uw-herron-lab/NeuroTest-Board/design_files/README.md

Parts acquisition and PCB production can be done through any supplier or partner that an end users chooses. While we do not endorse or support exclusive use of any manufacture or vendor, we provide information below detailing how we initially handled parts acquisition:

PCBs and the majority of parts were initially acquired through JLCPCB (https://jlcpcb.com/). The zipped folder containing the Gerber files can be uploaded to generate the PCB. The bom (and cpl) file contained in this subfolder can be uploaded to JLCPCB to generate an order of available parts. Parts that were not available through JLC were searched for on digipart (https://www.digipart.com/) and acquired through other suppliers like Digi-key or Unikey.

Another option used for initial parts ordering by one of our teams was LCSC (https://www.lcsc.com/). Again, parts that were not available were acquired on Digi-key or Unikey. NOTE: the "1Meg" component is a 1 mega Ohm (1Mohm) resistor with a 0603 footprint. LCSC appears to not register this part but it can be found by searching manually for these specifications. For example searching for 1M ohm 0603 will give you parts that work, including Part number: RC0603FR-071ML from YAGEO.

Though not a necessary service for NTB assembly, vendors like JLCPCB will both create the PCB and mount components (e.g., integrated circuits/ICs) that they are able to supply. End users should double check that the components are oriented correctly between the cpl and PCB layout. We used JLC to assemble most of the components, however, the BNC connectors (j1, J5, J6, J7), Teensy board (IC8), and power supply (PS1) were SMD soldered onto the PCBs by the labs themselves. 

The LED1, IC26, and IC27 components are not placed. SJ2 and SJ3 are pads and are not actual components (i.e., are also not placed).
