uw-herron-lab/NeuroTest-Board/data_files/README.md

Data that can be used with the signal generator function of the NTB can be found at the linked Open Science Framework repository (link: https://osf.io/3v24t/overview).
