uw-herron-lab/NeuroTest-Board/design_files/Sensing_circuit_diagram.png

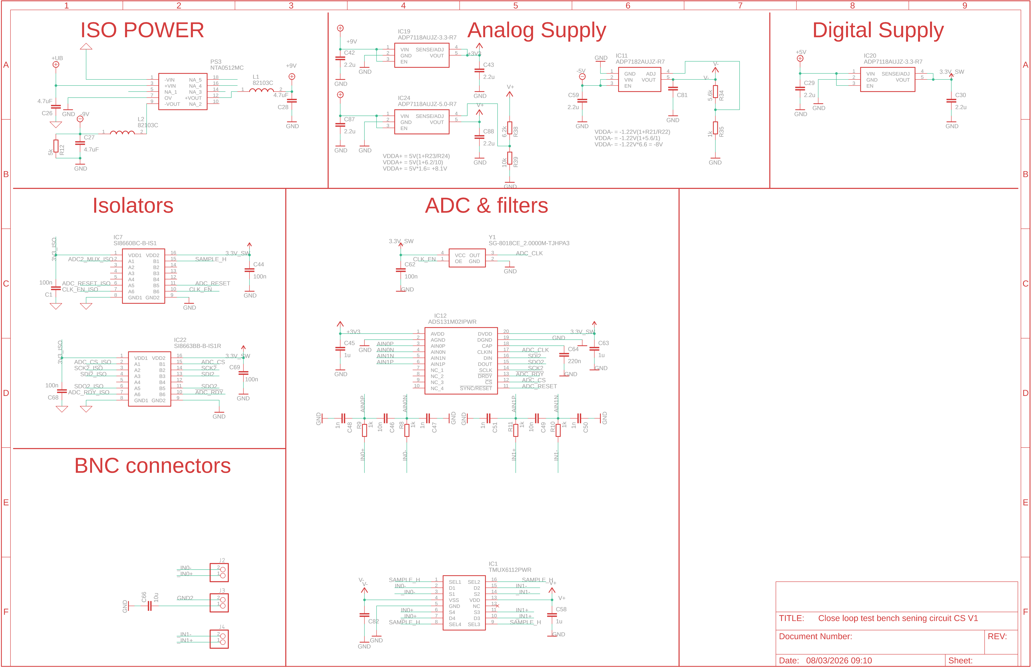
design_files/Sensing_circuit_diagram.png
