uw-herron-lab/NeuroTest-Board/design_files/NeuroTest board BOM and Digikey Order.xlsx

Sheet: BOM
Reference | Qty | Value | DNP | Exclude from BOM | Exclude from Board | Exclude from Simulation | Exclude from Position Files | Footprint | Datasheet
C2,C26,C27,C28 | 4 | 4.7uF |  |  |  |  | ${EXCLUDE_FROM_POS_FILES} | NeuroTest board current source 2 channel V1_1:C0603
C3,C54 | 2 | 1uF |  |  |  |  | ${EXCLUDE_FROM_POS_FILES} | NeuroTest board current source 2 channel V1_1:C0603
C4,C55 | 2 | 3.3uF |  |  |  |  | ${EXCLUDE_FROM_POS_FILES} | NeuroTest board current source 2 channel V1_1:C0603
C5,C6,C7,C8,C9,C10,C12,C14,C17,C20,C21,C29,C30,C42,C43,C52,C53,C60,C61,C67,C71,C75 | 22 | 2.2u |  |  |  |  | ${EXCLUDE_FROM_POS_FILES} | NeuroTest board current source 2 channel V1_1:C0603
C11,C13,C16,C45,C63,C65,C70,C74 | 8 | 1u |  |  |  |  | ${EXCLUDE_FROM_POS_FILES} | NeuroTest board current source 2 channel V1_1:C0603
C15,C73 | 2 | 3.3uF |  |  |  |  | ${EXCLUDE_FROM_POS_FILES} | NeuroTest board current source 2 channel V1_1:C0805
C18,C76 | 2 | 15p |  |  |  |  | ${EXCLUDE_FROM_POS_FILES} | NeuroTest board current source 2 channel V1_1:C0603
C22,C24,C31,C32,C62,C68,C69,C72 | 8 | 100n |  |  |  |  | ${EXCLUDE_FROM_POS_FILES} | NeuroTest board current source 2 channel V1_1:C0603
C46,C49 | 2 | 10n |  |  |  |  | ${EXCLUDE_FROM_POS_FILES} | NeuroTest board current source 2 channel V1_1:C0603
C47,C48,C50,C51 | 4 | 1n |  |  |  |  | ${EXCLUDE_FROM_POS_FILES} | NeuroTest board current source 2 channel V1_1:C0603
C56,C57,C83,C84 | 4 | 100nF |  |  |  |  | ${EXCLUDE_FROM_POS_FILES} | NeuroTest board current source 2 channel V1_1:C0603
C64 | 1 | 220n |  |  |  |  | ${EXCLUDE_FROM_POS_FILES} | NeuroTest board current source 2 channel V1_1:C0603
C66 | 1 | 10u |  |  |  |  | ${EXCLUDE_FROM_POS_FILES} | NeuroTest board current source 2 channel V1_1:C0603
DAC1,DAC3 | 2 | DAC8831ID |  |  |  |  | ${EXCLUDE_FROM_POS_FILES} | NeuroTest board current source 2 channel V1_1:SOIC127P600X175-14N
IC2,IC3,IC14,IC15 | 4 | OPA2192IDR_BKN |  |  |  |  | ${EXCLUDE_FROM_POS_FILES} | NeuroTest board current source 2 channel V1_1:SOIC127P600X175-8N
IC4 | 1 | SI8660BC-B-IS1 |  |  |  |  | ${EXCLUDE_FROM_POS_FILES} | NeuroTest board current source 2 channel V1_1:SOIC127P600X175-16N
IC6 | 1 | SI8663BB-B-IS1R |  |  |  |  | ${EXCLUDE_FROM_POS_FILES} | NeuroTest board current source 2 channel V1_1:SOIC127P600X175-16N
IC8 | 1 | TEENSY_4.1 |  |  |  |  | ${EXCLUDE_FROM_POS_FILES} | NeuroTest board current source 2 channel V1_1:TEENSY41
IC10,IC18,IC21 | 3 | ADP7118AUJZ-5.0-R7 |  |  |  |  | ${EXCLUDE_FROM_POS_FILES} | NeuroTest board current source 2 channel V1_1:SOT95P280X100-5N
IC12 | 1 | ADS131M02IPWR |  |  |  |  | ${EXCLUDE_FROM_POS_FILES} | NeuroTest board current source 2 channel V1_1:SOP65P640X120-20N
IC19,IC20 | 2 | ADP7118AUJZ-3.3-R7 |  |  |  |  | ${EXCLUDE_FROM_POS_FILES} | NeuroTest board current source 2 channel V1_1:SOT95P280X100-5N
IC22 | 1 | SI8662AB-B-IS1 |  |  |  |  | ${EXCLUDE_FROM_POS_FILES} | NeuroTest board current source 2 channel V1_1:SOIC127P600X175-16N
IC23,IC28 | 2 | OPA192IDGKT |  |  |  |  | ${EXCLUDE_FROM_POS_FILES} | NeuroTest board current source 2 channel V1_1:SOP65P490X110-8N
IC25 | 1 | ADP7182AUJZ-R7 |  |  |  |  | ${EXCLUDE_FROM_POS_FILES} | NeuroTest board current source 2 channel V1_1:SOT95P280X100-5N
IC26,IC27 | 2 | TXU0101DCKR |  |  |  |  | ${EXCLUDE_FROM_POS_FILES} | NeuroTest board current source 2 channel V1_1:SOT65P210X110-6N
J1,J5,J6,J7 | 4 | B6252H5-NPP3G-50 |  |  |  |  | ${EXCLUDE_FROM_POS_FILES} | NeuroTest board current source 2 channel V1_1:B6252H5NPP3G50
J3,TTL_IN0 | 2 | JST_2PIN-THM |  |  |  |  | ${EXCLUDE_FROM_POS_FILES} | NeuroTest board current source 2 channel V1_1:JST-PH-2-THM
L1,L2 | 2 | 82103C |  |  |  |  | ${EXCLUDE_FROM_POS_FILES} | NeuroTest board current source 2 channel V1_1:8200
LED1 | 1 | WS2812B-B_W |  |  |  |  | ${EXCLUDE_FROM_POS_FILES} | NeuroTest board current source 2 channel V1_1:WS2812BBW
LEDS0 | 1 | 2355045-4 |  |  |  |  | ${EXCLUDE_FROM_POS_FILES} | NeuroTest board current source 2 channel V1_1:HDRV4W50P0X200_1X4_800X200X550
PS1 | 1 | TMH_0515D |  |  |  |  | ${EXCLUDE_FROM_POS_FILES} | NeuroTest board current source 2 channel V1_1:TMH0515D
PS3 | 1 | NTA0505MC |  |  |  |  | ${EXCLUDE_FROM_POS_FILES} | NeuroTest board current source 2 channel V1_1:SOP254P1080X685-10N
R1 | 1 | 10.5k |  |  |  |  | ${EXCLUDE_FROM_POS_FILES} | NeuroTest board current source 2 channel V1_1:R0603
R2,R8,R9,R10,R11,R12 | 6 | 1k |  |  |  |  | ${EXCLUDE_FROM_POS_FILES} | NeuroTest board current source 2 channel V1_1:R0603
R3,R4,R5,R6,R13,R16,R18,R24,R43,R44,R45,R46,R49,R52,R54 | 15 | 10k |  |  |  |  | ${EXCLUDE_FROM_POS_FILES} | NeuroTest board current source 2 channel V1_1:R0603
R7,R19,R20,R47,R55,R57 | 6 | 100k |  |  |  |  | ${EXCLUDE_FROM_POS_FILES} | NeuroTest board current source 2 channel V1_1:R0603
R14,R50 | 2 | 20k |  |  |  |  | ${EXCLUDE_FROM_POS_FILES} | NeuroTest board current source 2 channel V1_1:R0603
R15,R17,R51,R53 | 4 | 499 |  |  |  |  | ${EXCLUDE_FROM_POS_FILES} | NeuroTest board current source 2 channel V1_1:R0603
R23 | 1 | 28k |  |  |  |  | ${EXCLUDE_FROM_POS_FILES} | NeuroTest board current source 2 channel V1_1:R0603
R29,R30 | 2 | 1Meg |  |  |  |  | ${EXCLUDE_FROM_POS_FILES} | NeuroTest board current source 2 channel V1_1:R0603
R48,R56 | 2 | 680 |  |  |  |  | ${EXCLUDE_FROM_POS_FILES} | NeuroTest board current source 2 channel V1_1:R0603
SJ2,SJ3 | 2 | SJ2W |  |  |  |  | ${EXCLUDE_FROM_POS_FILES} | NeuroTest board current source 2 channel V1_1:SJ_2
Y1 | 1 | SG-8018CE_2.0000M-TJHPA3 |  |  |  |  | ${EXCLUDE_FROM_POS_FILES} | NeuroTest board current source 2 channel V1_1:SG8018CE20000MTJHPA3
 | 137

Sheet: DigiKey Parts
ICs
Reference | Qty | Value | DigiKey Part Number | DigiKey link
IC19 IC20 | 2 | ADP7118AUJZ-3.3-R7 | 505-ADP7118AUJZ-3.3-R7CT-ND | DigiKey (https://www.digikey.com/en/products/detail/analog-devices-inc/ADP7118AUJZ-3-3-R7/5056890)
IC10 IC18 IC21 | 3 | ADP7118AUJZ-5.0-R7 | 505-ADP7118AUJZ-5.0-R7CT-ND | DigiKey (https://www.digikey.com/en/products/detail/analog-devices-inc/ADP7118AUJZ-5-0-R7/5056891)
IC25 | 1 | ADP7182AUJZ-R7 | 505-ADP7182AUJZ-R7CT-ND | DigiKey (https://www.digikey.com/en/products/detail/analog-devices-inc/ADP7182AUJZ-R7/4901225)
IC12 | 1 | ADS131M02IPWR | 296-ADS131M02IPWRCT-ND | DigiKey (https://www.digikey.com/en/products/detail/texas-instruments/ADS131M02IPWR/15857267)
DAC1 DAC3 | 2 | DAC8831ID | 296-18030-5-ND | DigiKey (https://www.digikey.com/en/products/detail/texas-instruments/DAC8831ID/770869?utm_source=chatgpt.com)
PS3 | 1 | NTA0505MC | 811-1665-5-ND | DigiKey (https://www.digikey.com/en/products/detail/murata-power-solutions-inc/NTA0505MC/1927226)
IC23 IC28 | 2 | OPA192IDGKT | 296-42442-1-ND | DigiKey (https://www.digikey.com/en/products/detail/texas-instruments/OPA192IDGKT/5405191)
IC2 IC3 IC14 IC15 | 4 | OPA2192IDR_BKN | 296-42106-1-ND | DigiKey (https://www.digikey.com/en/products/detail/texas-instruments/OPA2192IDR/5252859)
IC4 | 1 | SI8660BC-B-IS1 | 336-2114-5-ND | DigiKey (https://www.digikey.com/en/products/detail/skyworks-solutions-inc/SI8660BC-B-IS1/2623362)
IC22 | 1 | SI8662AB-B-IS1 | SI8662AB-B-IS1-ND | DigiKey (https://www.digikey.com/en/products/detail/skyworks-solutions-inc/SI8662AB-B-IS1/4576760)
IC6 | 1 | SI8663BB-B-IS1R | 336-4949-1-ND | DigiKey (https://www.digikey.com/en/products/detail/skyworks-solutions-inc/SI8663BB-B-IS1R/4576621)
PS1 | 1 | TMH 0515D | 1951-2669-ND | DigiKey (https://www.digikey.com/en/products/detail/traco-power/TMH-0515D/9383703?utm_source=chatgpt.com)
IC8 | 1 | TEENSY 4.1 | 1568-16996-ND | DigiKey (https://www.digikey.com/en/products/detail/sparkfun-electronics/16996/13158152)
Resistors
Reference | Qty | Value | DigiKey Part Number | DigiKey link
R29 R30 | 2 | 1 MΩ | 311-1.00MHRCT-ND | DigiKey (https://www.digikey.com/en/products/detail/yageo/RC0603FR-071ML/729791?utm_source=chatgpt.com)
R2 R8 R9 R10 R11 R12 | 6 | 1 kΩ | 311-1.00KHRCT-ND | DigiKey (https://www.digikey.com/en/products/detail/yageo/RC0603FR-071KL/729790?utm_source=chatgpt.com)
R1 | 1 | 10.5 kΩ | 311-10.5KHRCT-ND | DigiKey (https://www.digikey.com/en/products/detail/yageo/RC0603FR-0710K5L/729832?utm_source=chatgpt.com)
R3 R4 R5 R6 R13 R16 R18 R24 R43 R44 R45 R46 R49 R52 R54 | 15 | 10 kΩ | 311-10.0KHRCT-ND | DigiKey (https://www.digikey.com/en/products/detail/yageo/RC0603FR-0710KL/729827?utm_source=chatgpt.com)
R14 R50 | 2 | 20 kΩ | 311-20.0KHRCT-ND | DigiKey (https://www.digikey.com/en/products/detail/yageo/RC0603FR-0720KL/727040)
R23 | 1 | 28 kΩ | 311-28.0KHRCT-ND | DigiKey (https://www.digikey.com/en/products/detail/yageo/RC0603FR-0728KL/727108?utm_source=chatgpt.com)
R7 R19 R20 R47 R55 R57 | 6 | 100 kΩ | 311-100KHRCT-ND | DigiKey (https://www.digikey.com/en/products/detail/yageo/RC0603FR-07100KL/726889?utm_source=chatgpt.com)
R15 R17 R51 R53 | 4 | 499 Ω | 311-499HRCT-ND | DigiKey (https://www.digikey.com/en/products/detail/yageo/RC0603FR-07499RL/727266?utm_source=chatgpt.com)
R48 R56 | 2 | 680 Ω | 311-680HRCT-ND | DigiKey (https://www.digikey.com/en/products/detail/yageo/RC0603FR-07680RL/730302?utm_source=chatgpt.com)
Capacitors
Reference | Qty | Value | DigiKey Part Number | DigiKey link | Notes
C18 C76 | 2 | 15 pF | 399-C0603C150J5GACTUCT-ND | DigiKey (https://www.digikey.com/en/products/detail/kemet/C0603C150J5GACTU/411053?utm_source=chatgpt.com)
C47 C48 C50 C51 | 4 | 1 nF | 399-C0603C102J5GACTUCT-ND | DigiKey (https://www.digikey.com/en/products/detail/kemet/C0603C102J5GACTU/608471?utm_source=chatgpt.com)
C46 C49 | 2 | 10 nF | 490-9666-1-ND | DigiKey (https://www.digikey.com/en/products/detail/murata-electronics/GRM1885C1H103JA01D/4421555)
C22 C24 C31 C32 C56 C57 C62 C68 C69 C72 C83 C84 | 12 | 100 nF | 399-C0603C104K5RACTUCT-ND | DigiKey (https://www.digikey.com/en/products/detail/kemet/C0603C104K5RACTU/1465623?utm_source=chatgpt.com)
C64 | 1 | 220 nF | 490-5402-1-ND | DigiKey (https://www.digikey.com/en/products/detail/murata-electronics/GCM188R71H224KA64D/2123159)
C3 C11 C13 C16 C45 C54 C63 C65 C70 C74 | 10 | 1 µF | 445-12484-1-ND | DigiKey (https://www.digikey.com/en/products/detail/tdk-corporation/CGA3E3X5R1V105K080AB/3954150)
C5 C6 C7 C8 C9 C10 C12 C14 C17 C20 C21 C29 C30 C42 C43 C52 C53 C60 C61 C67 C71 C75 | 22 | 2.2 µF | 490-7204-1-ND | DigiKey (https://www.digikey.com/en/products/detail/murata-electronics/GRM188R6YA225KA12D/3900462)
C4 C15 C55 C73 | 4 | 3.3 µF | 445-14167-1-ND | DigiKey (https://www.digikey.com/en/products/detail/tdk-corporation/C1608X5R1V335K080AC/3955833) | C15 and C73 are supposed to be 0805 (2012) but the 0603 (1608) work
C2 C26 C27 C28 | 4 | 4.7 µF | 490-GRM188R6YA475KE15JCT-ND | DigiKey (https://www.digikey.com/en/products/detail/murata-electronics/GRM188R6YA475KE15J/4905369)
C66 | 1 | 10 µF | 490-GRM188R6YA106MA73JTR-ND | DigiKey (https://www.digikey.com/en/products/detail/murata-electronics/GRM188R6YA106MA73J/13693159)
Everything Else
Reference | Qty | Value | DigiKey Part Number | DigiKey link
J1 J5 J6 J7 | 4 | B6252H5-NPP3G-50 | ARF1690-ND | DigiKey (https://www.digikey.com/en/products/detail/amphenol-rf/031-5431-10RFX/2041816?utm_source=chatgpt.com)
Y1 | 1 | SG-8018CE 2.048000MHz TJHPA | SG-8018CE-TJHPA-ND † | DigiKey (https://www.digikey.com/en/products/detail/epson/SG-8018CE-TJHPA/7784068)
L1 L2 | 2 | 82103C | 811-2473-1-ND | DigiKey (https://www.digikey.com/en/products/detail/murata-power-solutions-inc/82103C/3178927)
