uw-herron-lab/NeuroTest-Board/design_files/NTB_schematic.kicad_sch

## KiCad design design_files/NTB_schematic.kicad_sch (2026-09-11)

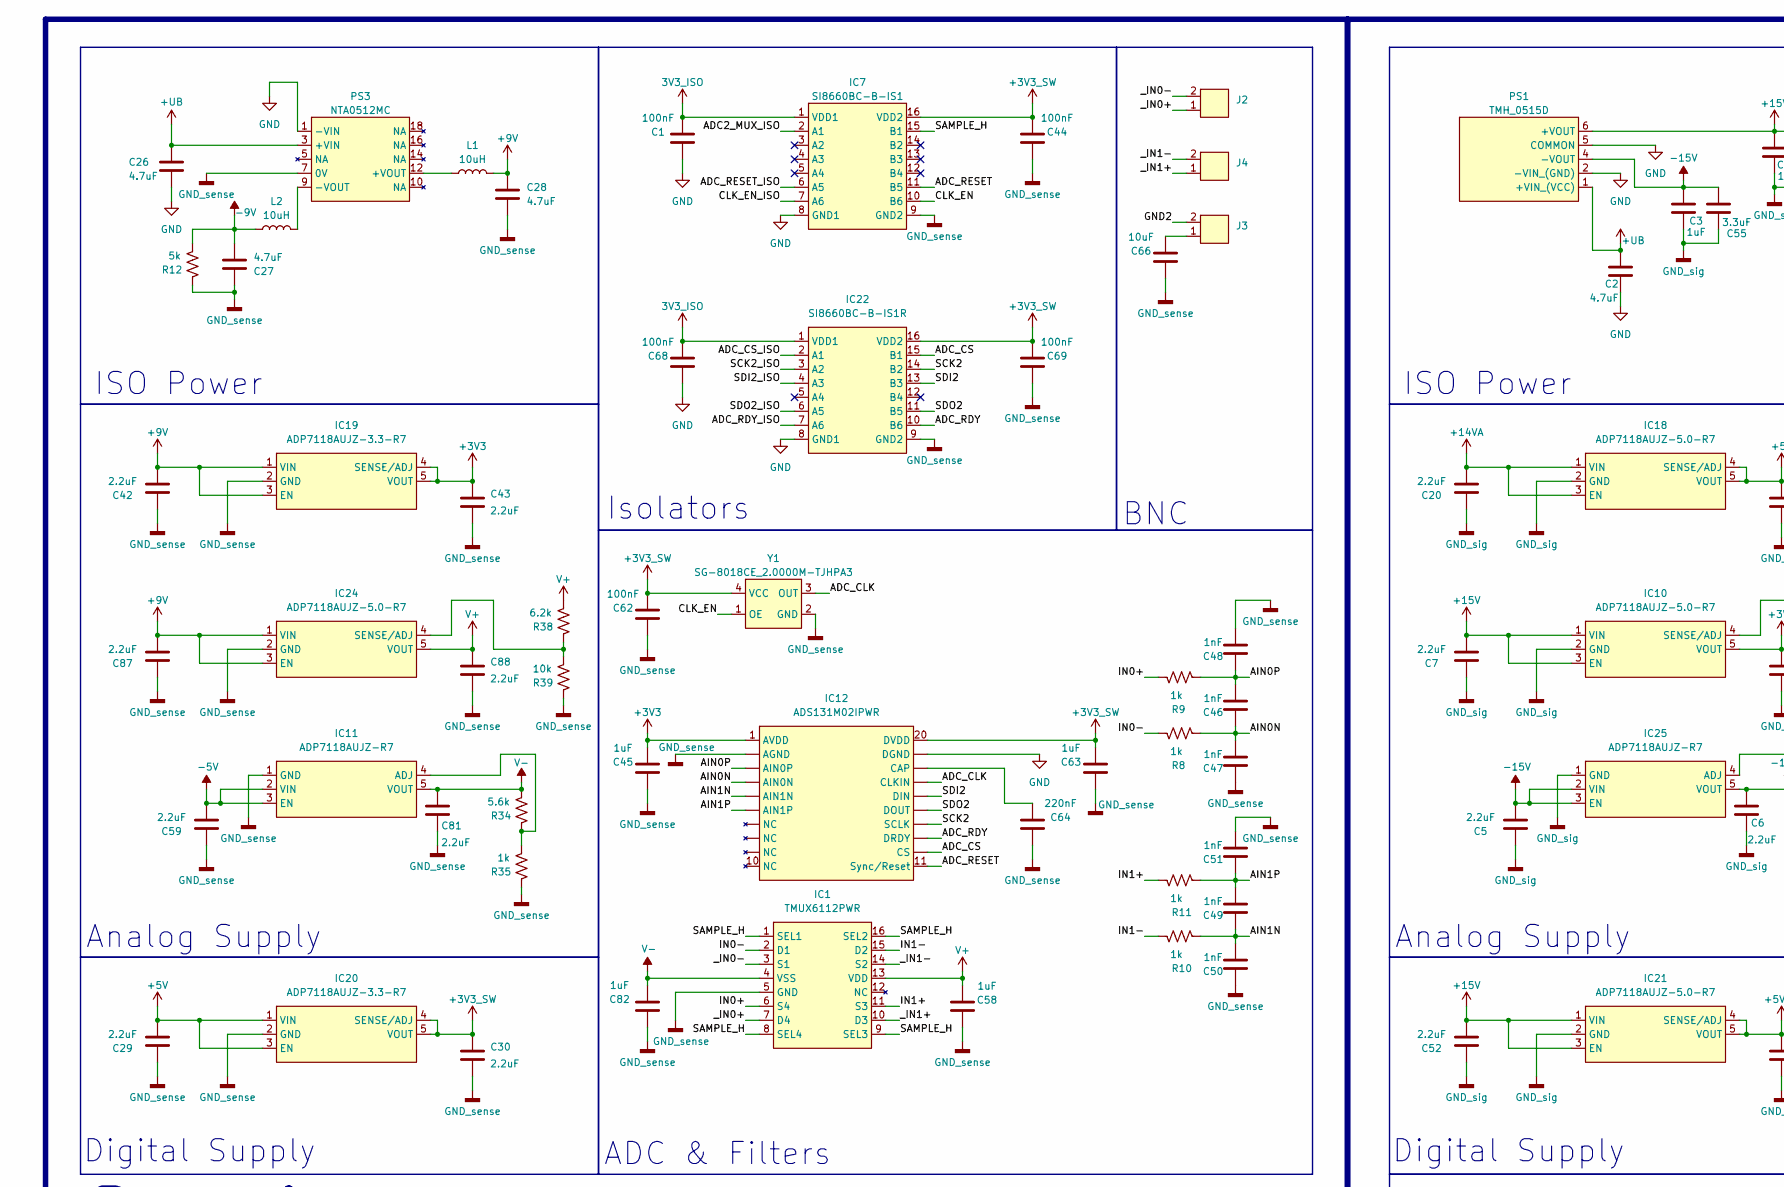
[picture p8: schematic NTB_schematic.kicad_sch, part in row 1, column 1]

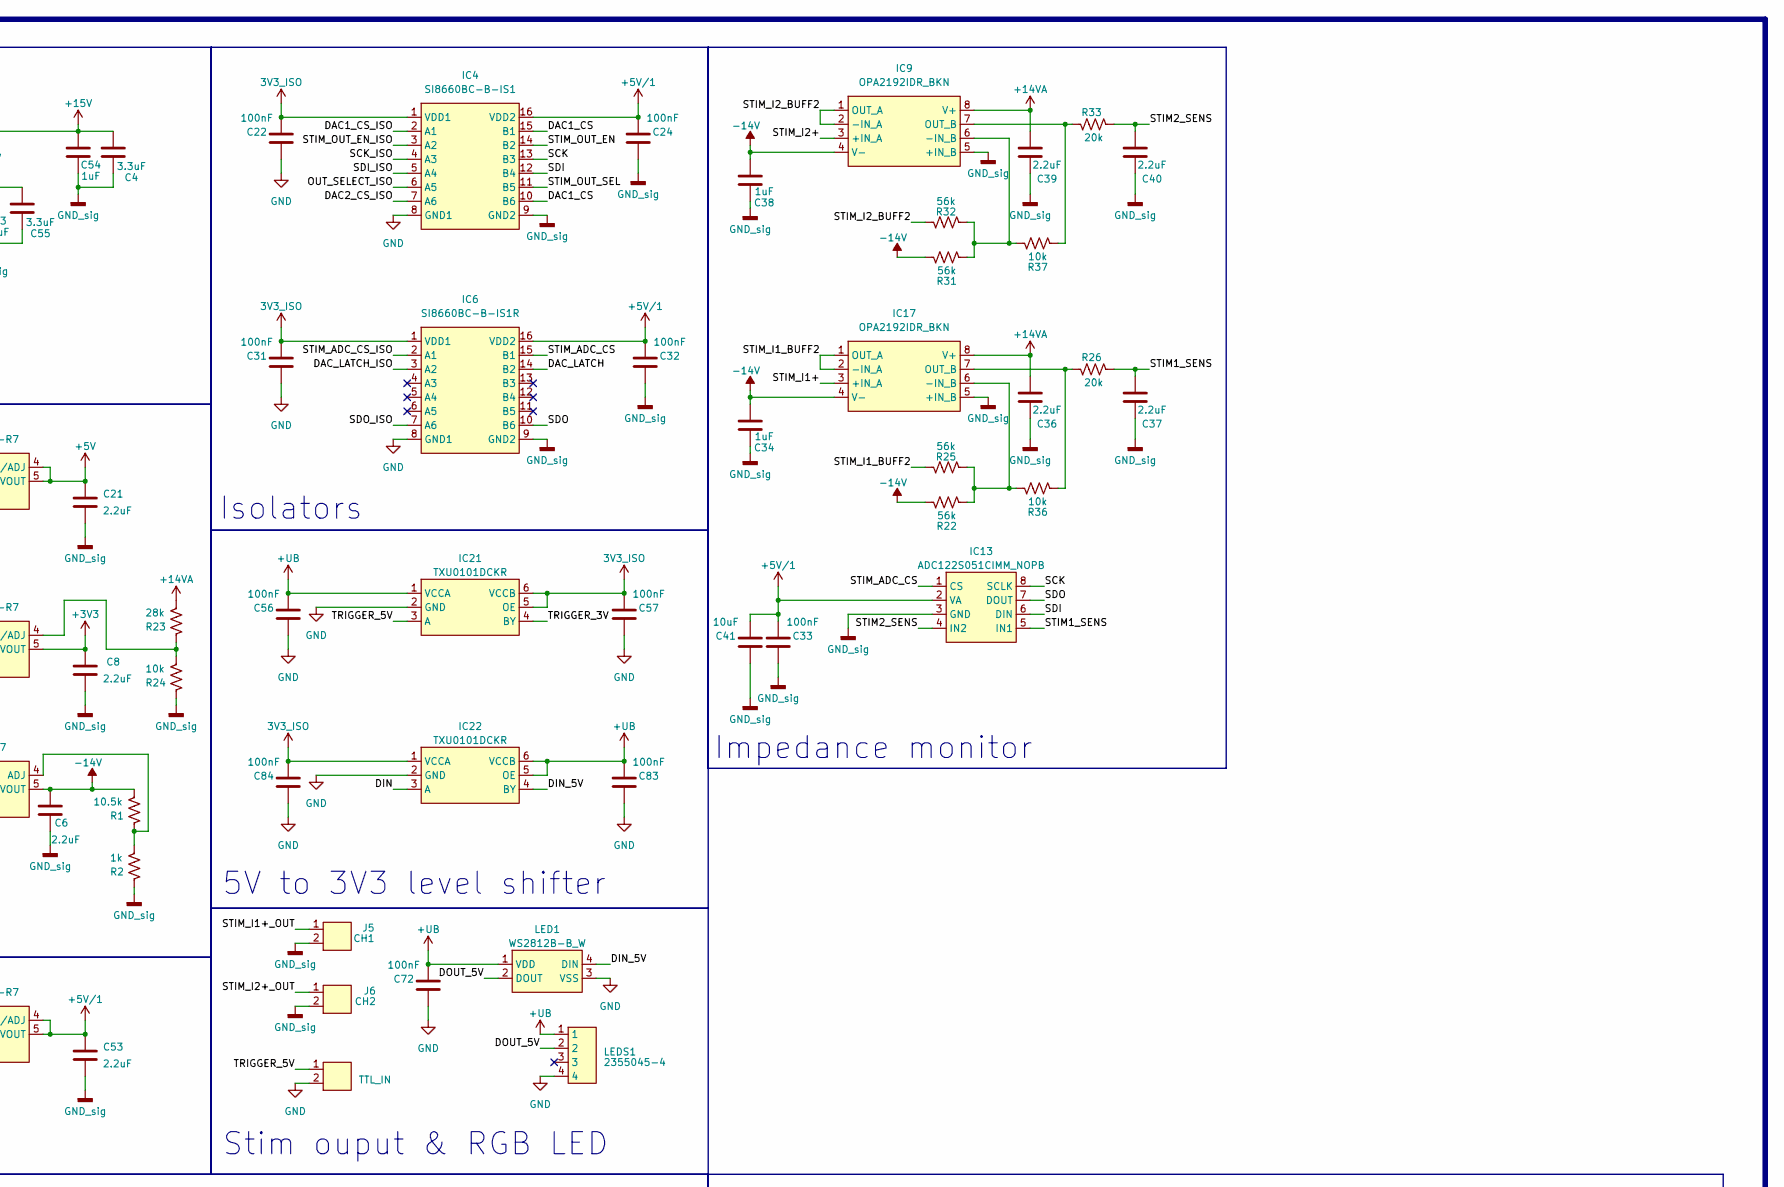
[picture p9: schematic NTB_schematic.kicad_sch, part in row 1, column 2]

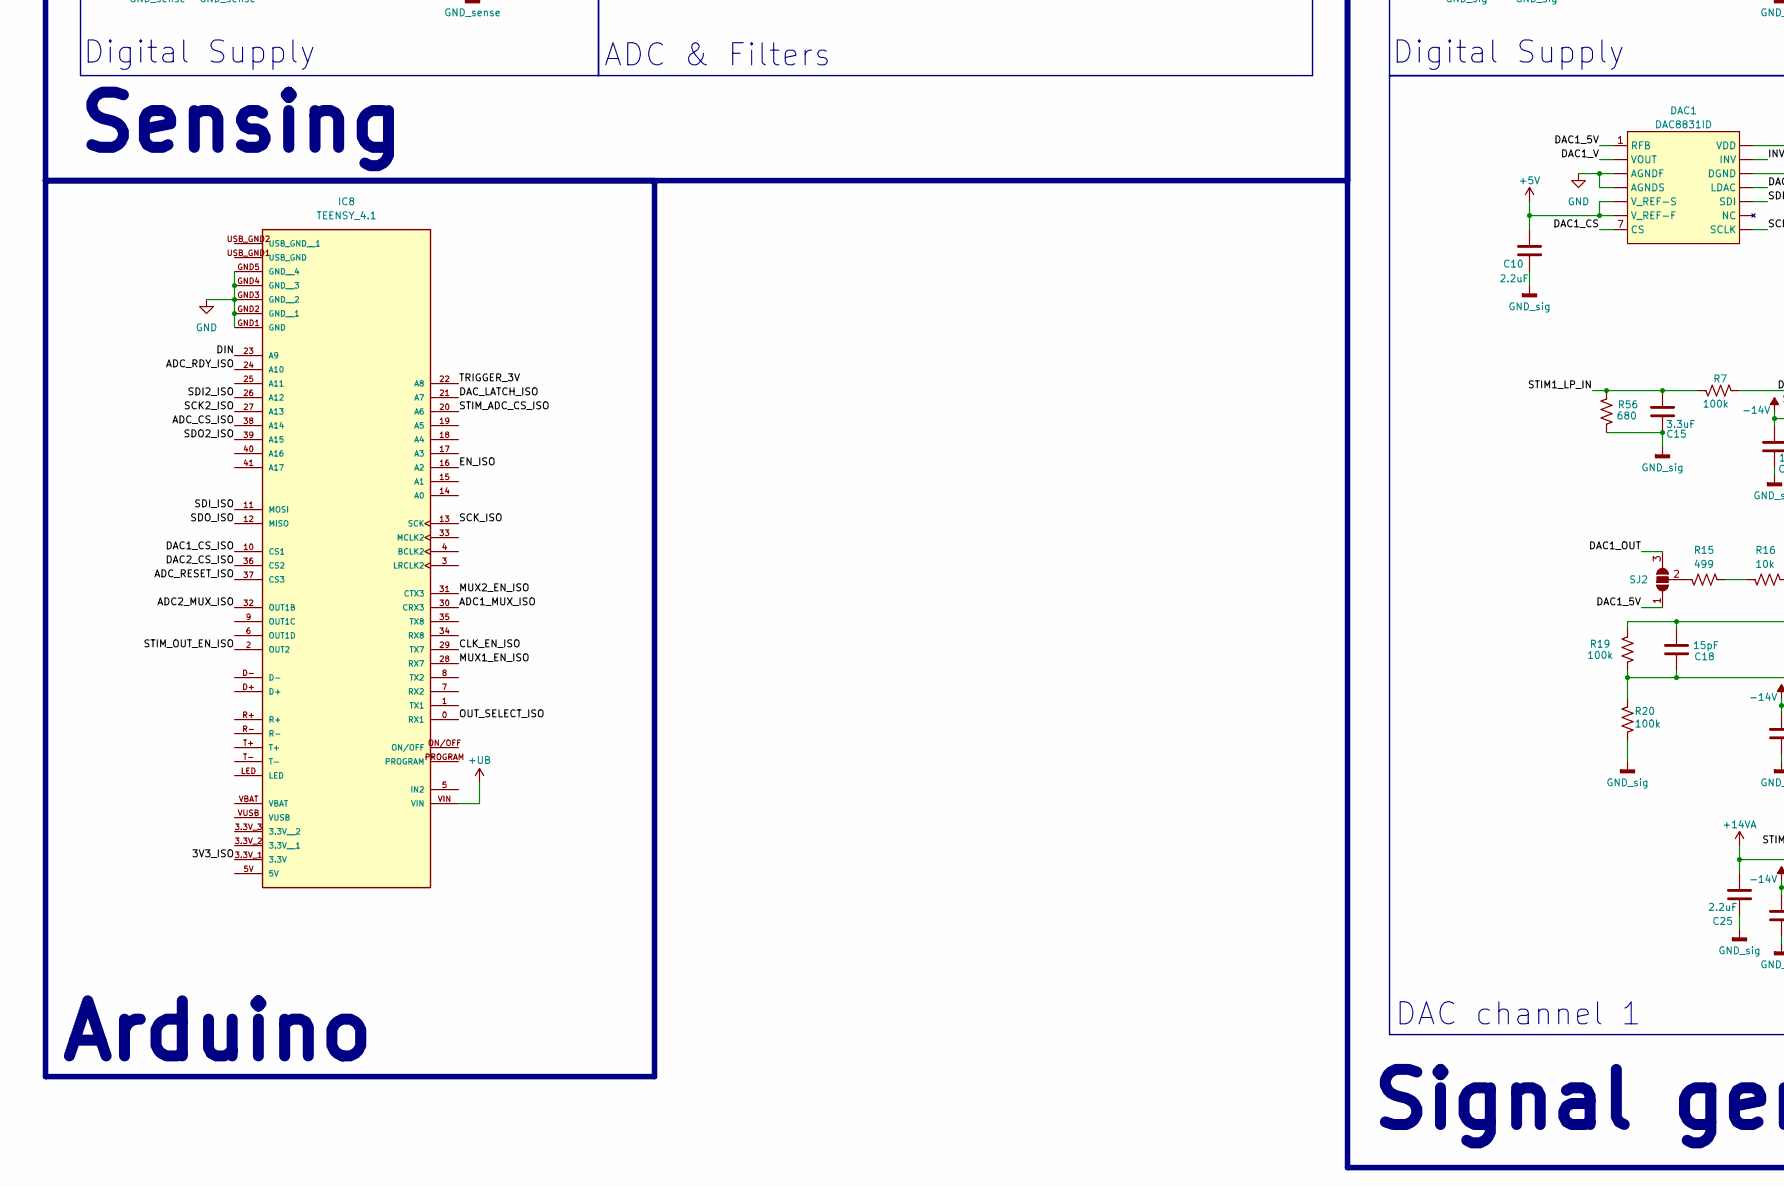
[picture p10: schematic NTB_schematic.kicad_sch, part in row 2, column 1]

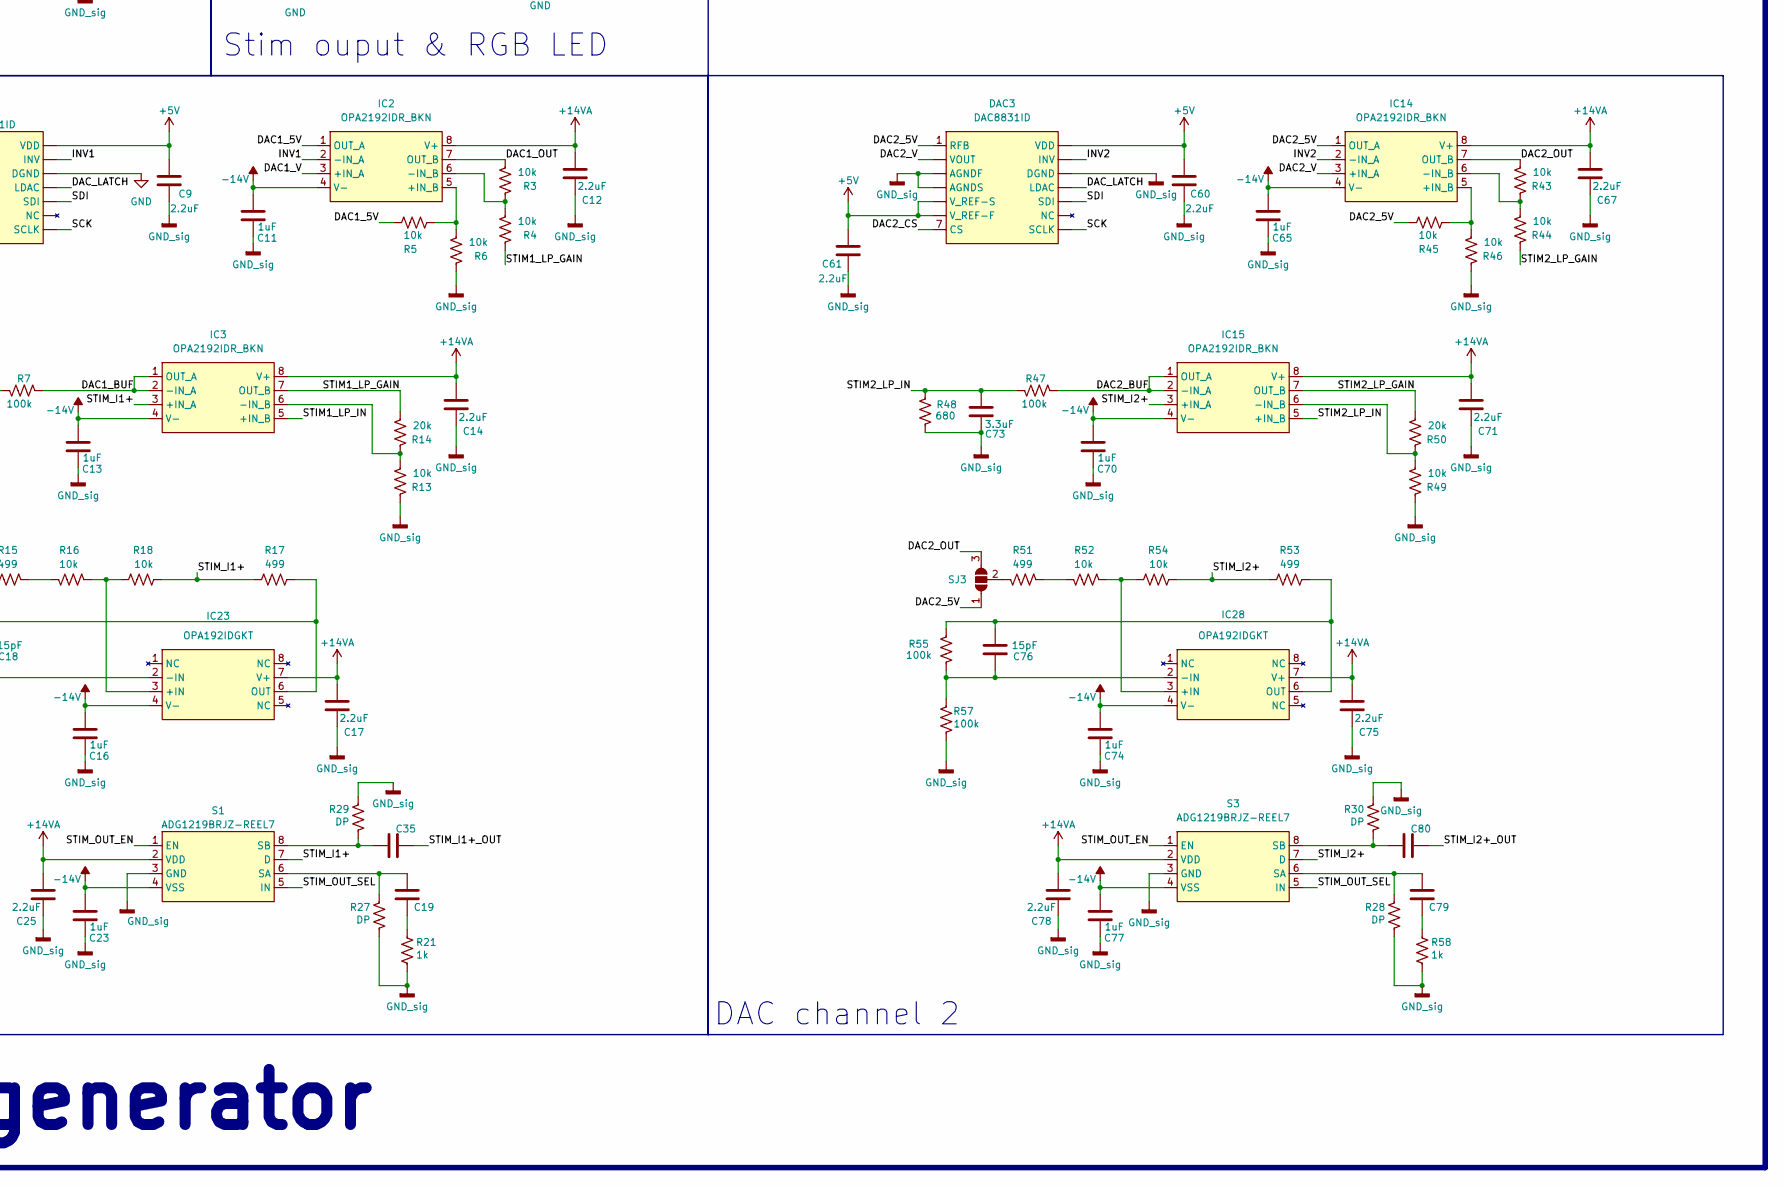
[picture p11: schematic NTB_schematic.kicad_sch, part in row 2, column 2]

Parts:
C1, C22, C24, C31, C32, C33, C44, C56, C57, C62, C68, C69, C72, C83, C84: 100nF
C2, C26, C27, C28: 4.7uF
C3, C11, C13, C16, C23, C34, C38, C45, C54, C58, C63, C65, C70, C74, C77, C82: 1uF
C4, C15, C55, C73: 3.3uF
C5, C6, C7, C8, C9, C10, C12, C14, C17, C20, C21, C25, C29, C30, C36, C37, C39, C40, C42, C43, C52, C53, C59, C60, C61, C67, C71, C75, C78, C81, C87, C88: 2.2uF
C18, C76: 15pF
C19, C35, C79, C80: (no value)
C41, C66: 10uF
C46, C47, C48, C49, C50, C51: 1nF
C64: 220nF
DAC1, DAC3: DAC8831ID
IC1: TMUX6112PWR
IC2, IC3, IC9, IC14, IC15, IC17: OPA2192IDR_BKN
IC4, IC7: SI8660BC-B-IS1
IC6, IC22: SI8660BC-B-IS1R
IC8: TEENSY_4.1; MODULE_DEV-16771; PARTREV 4.1
IC10, IC18, IC24: ADP7118AUJZ-5.0-R7
IC11, IC25: ADP7118AUJZ-R7
IC12: ADS131M02IPWR
IC13: ADC122S051CIMM_NOPB
IC19, IC20: ADP7118AUJZ-3.3-R7
IC21: TXU0101DCKR
IC23, IC28: OPA192IDGKT
J2, J3, J4: (no value)
J5: CH1
J6: CH2
L1, L2: 10uH
LED1: WS2812B-B_W
LEDS1: 2355045-4
PS1: TMH_0515D
PS3: NTA0512MC
R1: 10.5k
R2, R8, R9, R10, R11, R21, R35, R58: 1k
R3, R4, R5, R6, R13, R16, R18, R24, R36, R37, R39, R43, R44, R45, R46, R49, R52, R54: 10k
R7, R19, R20, R47, R55, R57: 100k
R12: 5k
R14, R26, R33, R50: 20k
R15, R17, R51, R53: 499
R22, R25, R31, R32: 56k
R23: 28k
R27, R28, R29, R30: DP
R34: 5.6k
R38: 6.2k
R48, R56: 680
S1, S3: ADG1219BRJZ-REEL7
SJ2, SJ3: (no value)
TTL_IN: (no value)
Y1: SG-8018CE_2.0000M-TJHPA3

Connections:
3V3_ISO: C1.1, C22.1, C31.1, C57.1, C68.1, C84.1, IC4.1 (VDD1), IC6.1 (VDD1), IC7.1 (VDD1), IC8.3.3V_1 (3.3V), IC21.5 (VOUT), IC21.6 (VCCB), IC22.1 (VCCA)
+3V3: C8.1, C43.1, C45.1, IC10.5 (VOUT), IC12.1 (AVDD), IC19.4 (SENSE/ADJ), IC19.5 (VOUT)
+3V3_SW: C30.1, C44.1, C62.1, C63.1, C69.1, IC7.16 (VDD2), IC12.20 (DVDD), IC20.4 (SENSE/ADJ), IC20.5 (VOUT), IC22.16 (VDD2), Y1.4 (VCC)
+5V: C9.2, C10.2, C21.1, C29.2, C60.2, C61.2, DAC1. (VOUT), DAC3. (VOUT), IC18.4 (SENSE/ADJ), IC18.5 (VOUT), IC20.1 (VIN), IC20.3 (EN)
+5V/1: C24.1, C32.1, C33.1, C41.1, C53.1, IC4.16 (VDD2), IC6.16 (VDD2), IC13.2 (VA), IC21.4 (SENSE/ADJ), IC21.5 (VOUT)
+9V: C28.1, C42.2, C87.2, IC19.1 (VIN), IC19.3 (EN), IC24.1 (VIN), IC24.3 (EN), L1.2
+14VA: C12.2, C14.2, C17.2, C20.2, C25.2, C36.2, C39.2, C67.2, C71.2, C75.2, C78.2, IC2.8 (V+), IC3.8 (V+), IC9.8 (V+), IC14.8 (V+), IC15.8 (V+), IC17.8 (V+), IC18.1 (VIN), IC18.3 (EN), IC23.7 (V+), IC28.7 (V+), R23.2, S1.2 (VDD), S3.2 (VDD)
+15V: C4.2, C7.2, C52.2, C54.1, IC10.1 (VIN), IC10.3 (EN), IC21.1 (VIN), IC21.3 (EN), PS1.6 (+VOUT)
+UB: C2.1, C26.1, C56.1, C72.1, C83.1, IC8.VIN, IC21.1 (VIN), IC22.5 (OE), IC22.6 (VCCB), LED1.1 (VDD), LEDS1.1, PS1.1 (+VIN_(VCC)), PS3.3 (+VIN)
-5V: C59.2, IC11.2 (VIN), IC11.3 (EN)
-9V: C27.2, L2.1, R12.2
-14V: C6.1, C11.2, C13.2, C16.2, C23.2, C34.2, C38.2, C65.2, C70.2, C74.2, C77.2, IC2.4 (V-), IC3.4 (V-), IC9.4 (V-), IC14.4 (V-), IC15.4 (V-), IC17.4 (V-), IC23.4 (V-), IC25.5 (VOUT), IC28.4 (V-), R1.2, R22.2, R31.2, S1.4 (VSS), S3.4 (VSS)
-15V: C3.1, C5.2, C55.2, IC25.2 (VIN), IC25.3 (EN), PS1.4 (-VOUT)
ADC1_MUX_ISO: IC8.30 (CRX3)
ADC2_MUX_ISO: IC7.2 (A1), IC8.32 (OUT1B)
ADC_CLK: IC12. (AGND), Y1.3 (OUT)
ADC_CS: IC12. (AGND), IC22.15 (B1)
ADC_CS_ISO: IC8.38 (A14), IC22.2 (GND)
ADC_RDY: IC12. (AGND), IC22.10 (B6)
ADC_RDY_ISO: IC8.24 (A10), IC22.7 (A6)
ADC_RESET: IC7.11 (B5), IC12.11 (Sync/Reset)
ADC_RESET_ISO: IC7.6 (A5), IC8.37 (CS3)
AIN0N: C46.2, C47.1, IC12. (AGND), R8.1
AIN0P: C46.1, C48.2, IC12. (AGND), R9.1
AIN1N: C49.2, C50.1, IC12. (AGND), R10.1
AIN1P: C49.1, C51.2, IC12. (AGND), R11.1
CLK_EN: IC7.10 (B6), Y1.1 (OE)
CLK_EN_ISO: IC7.7 (A6), IC8.29 (TX7)
DAC1_5V: DAC1.1 (RFB), IC2.1 (OUT_A), R5.1, SJ2.1 (A)
DAC1_BUF: IC3.1 (OUT_A), IC3.2 (-IN_A), R7.1
DAC1_CS: DAC1.7 (CS), IC4.10 (B6), IC4.15 (B1)
DAC1_CS_ISO: IC4.2 (A1), IC8.10 (CS1)
DAC1_OUT: IC2.7 (OUT_B), R3.1, SJ2.3 (B)
DAC1_V: DAC1. (VOUT), IC2.3 (+IN_A)
DAC2_5V: DAC3.1 (RFB), IC14.1 (OUT_A), R45.1, SJ3.1 (A)
DAC2_BUF: IC15.1 (OUT_A), IC15.2 (-IN_A), R47.1
DAC2_CS: DAC3.7 (CS)
DAC2_CS_ISO: IC4.7 (A6), IC8.36 (CS2)
DAC2_OUT: IC14.7 (OUT_B), R43.1, SJ3.3 (B)
DAC2_V: DAC3. (VOUT), IC14.3 (+IN_A)
DAC_LATCH: DAC1. (VOUT), DAC3. (VOUT), IC6.14 (B2)
DAC_LATCH_ISO: IC6.3 (A2), IC8.21 (A7)
DIN: IC8.23 (A9), IC22.3 (A)
DIN_5V: IC22.4 (BY), LED1.4 (DIN)
DOUT_5V: LED1.2 (DOUT), LEDS1.2
EN_ISO: IC8.16 (A2)
GND: C1.2, C2.2, C22.2, C26.2, C31.2, C56.2, C57.2, C68.2, C72.2, C83.2, C84.2, DAC1. (VOUT), IC4.8 (GND1), IC6.8 (GND1), IC7.8 (GND1), IC8.GND1 (GND), IC8.GND2 (GND__1), IC8.GND3 (GND__2), IC8.GND4 (GND__3), IC8.GND5 (GND__4), IC12. (AGND), IC21.2 (GND), IC22.2 (GND), IC22.8 (GND1), LED1.3 (VSS), LEDS1.4, PS1.2 (-VIN_(GND)), PS1.5 (COMMON), PS3.1 (-VIN), TTL_IN.2
GND2: J3.2
GND_sense: C27.1, C28.2, C29.1, C30.2, C42.1, C43.2, C44.2, C45.2, C47.2, C48.1, C50.2, C51.1, C58.2, C59.1, C62.2, C63.2, C64.2, C66.2, C69.2, C81.2, C82.2, C87.1, C88.2, IC1.5 (GND), IC7.9 (GND2), IC11.1 (GND), IC12. (AGND), IC19.2 (GND), IC20.2 (GND), IC22.9 (GND2), IC24.2 (GND), PS3.7 (0V), R12.1, R35.1, R39.1, Y1.2 (GND)
GND_sig: C3.2, C4.1, C5.1, C6.2, C7.1, C8.2, C9.1, C10.1, C11.1, C12.1, C13.1, C14.1, C15.1, C16.1, C17.1, C20.1, C21.2, C23.1, C24.2, C25.1, C32.2, C33.2, C34.1, C36.1, C37.1, C38.1, C39.1, C40.1, C41.2, C52.1, C53.2, C54.2, C55.1, C60.1, C61.1, C65.1, C67.1, C70.1, C71.1, C73.1, C74.1, C75.1, C77.1, C78.1, DAC3. (VOUT), IC4.9 (GND2), IC6.9 (GND2), IC9.5 (+IN_B), IC10.2 (GND), IC13.3 (GND), IC17.5 (+IN_B), IC18.2 (GND), IC21.2 (GND), IC25.1 (GND), J5.2, J6.2, R2.1, R6.2, R13.2, R20.1, R21.1, R24.1, R27.1, R28.1, R29.2, R30.2, R46.2, R48.1, R49.2, R56.1, R57.1, R58.1, S1.3 (GND), S3.3 (GND)
IN0+: IC1.6 (S4), R9.2
IN0-: IC1.2 (D1), R8.2
IN1+: IC1.11 (S3), R11.2
IN1-: IC1.15 (D2), R10.2
INV1: DAC1. (VOUT), IC2.2 (-IN_A)
INV2: DAC3. (VOUT), IC14.2 (-IN_A)
MUX1_EN_ISO: IC8.28 (RX7)
MUX2_EN_ISO: IC8.31 (CTX3)
unnamed: C18.1, IC23.6 (OUT), R17.2, R19.2
unnamed: C18.2, IC23.2 (-IN), R19.1, R20.2
unnamed: C19.1, R21.2
unnamed: C19.2, R27.2, S1.6 (SA)
unnamed: C35.2, R29.1, S1.8 (SB)
unnamed: C64.1, IC12. (AGND)
unnamed: C66.1, J3.1
unnamed: C76.1, IC28.6 (OUT), R53.2, R55.2
unnamed: C76.2, IC28.2 (-IN), R55.1, R57.2
unnamed: C79.1, R58.2
unnamed: C79.2, R28.2, S3.6 (SA)
unnamed: C80.2, R30.1, S3.8 (SB)
unnamed: IC2.5 (+IN_B), R5.2, R6.1
unnamed: IC2.6 (-IN_B), R3.2, R4.1
unnamed: IC3.6 (-IN_B), R13.1, R14.2
unnamed: IC9.6 (-IN_B), R31.1, R32.1, R37.2
unnamed: IC9.7 (OUT_B), R33.2, R37.1
unnamed: IC10.4 (SENSE/ADJ), R23.1, R24.2
unnamed: IC11.4 (ADJ), R34.1, R35.2
unnamed: IC14.5 (+IN_B), R45.2, R46.1
unnamed: IC14.6 (-IN_B), R43.2, R44.1
unnamed: IC15.6 (-IN_B), R49.1, R50.2
unnamed: IC17.6 (-IN_B), R22.1, R25.1, R36.2
unnamed: IC17.7 (OUT_B), R26.2, R36.1
unnamed: IC23.3 (+IN), R16.1, R18.1
unnamed: IC24.4 (SENSE/ADJ), R38.1, R39.2
unnamed: IC25.4 (ADJ), R1.1, R2.2
unnamed: IC28.3 (+IN), R52.1, R54.1
unnamed: L1.1, PS3.12 (+VOUT)
unnamed: L2.2, PS3.9 (-VOUT)
unnamed: R15.1, R16.2
unnamed: R15.2, SJ2.2 (C)
unnamed: R51.1, R52.2
unnamed: R51.2, SJ3.2 (C)
OUT_SELECT_ISO: IC4.6 (A5), IC8.0 (RX1)
SAMPLE_H: IC1.1 (SEL1), IC1.8 (SEL4), IC1.9 (SEL3), IC1.16 (SEL2), IC7.15 (B1)
SCK: DAC1. (VOUT), DAC3. (VOUT), IC4.13 (B3), IC13.8 (SCLK)
SCK2: IC12. (AGND), IC22.14 (B2)
SCK2_ISO: IC8.27 (A13), IC22.3 (A)
SCK_ISO: IC4.4 (A3), IC8.13 (SCK)
SDI: DAC1. (VOUT), DAC3. (VOUT), IC4.12 (B4), IC13.6 (DIN)
SDI2: IC12. (AGND), IC22.13 (B3)
SDI2_ISO: IC8.26 (A12), IC22.4 (BY)
SDI_ISO: IC4.5 (A4), IC8.11 (MOSI)
SDO: IC6.10 (B6), IC13.7 (DOUT)
SDO2: IC12. (AGND), IC22.11 (B5)
SDO2_ISO: IC8.39 (A15), IC22.6 (VCCB)
SDO_ISO: IC6.7 (A6), IC8.12 (MISO)
STIM1_LP_GAIN: IC3.7 (OUT_B), R4.2, R14.1
STIM1_LP_IN: C15.2, IC3.5 (+IN_B), R7.2, R56.2
STIM1_SENS: C37.2, IC13.5 (IN1), R26.1
STIM2_LP_GAIN: IC15.7 (OUT_B), R44.2, R50.1
STIM2_LP_IN: C73.2, IC15.5 (+IN_B), R47.2, R48.2
STIM2_SENS: C40.2, IC13.4 (IN2), R33.1
STIM_ADC_CS: IC6.15 (B1), IC13.1 (CS)
STIM_ADC_CS_ISO: IC6.2 (A1), IC8.20 (A6)
STIM_I1+: IC3.3 (+IN_A), IC17.3 (+IN_A), R17.1, R18.2, S1.7 (D)
STIM_I1+_OUT: C35.1, J5.1
STIM_I1_BUFF2: IC17.1 (OUT_A), IC17.2 (-IN_A), R25.2
STIM_I2+: IC9.3 (+IN_A), IC15.3 (+IN_A), R53.1, R54.2, S3.7 (D)
STIM_I2+_OUT: C80.1, J6.1
STIM_I2_BUFF2: IC9.1 (OUT_A), IC9.2 (-IN_A), R32.2
STIM_OUT_EN: IC4.14 (B2), S1.1 (EN), S3.1 (EN)
STIM_OUT_EN_ISO: IC4.3 (A2), IC8.2 (OUT2)
STIM_OUT_SEL: IC4.11 (B5), S1.5 (IN), S3.5 (IN)
TRIGGER_3V: IC8.22 (A8), IC21.4 (SENSE/ADJ)
TRIGGER_5V: IC21.3 (EN), TTL_IN.1
V+: C58.1, C88.1, IC1.13 (VDD), IC24.5 (VOUT), R38.2
V-: C81.1, C82.1, IC1.4 (VSS), IC11.5 (VOUT), R34.2
_IN0+: IC1.7 (D4), J2.1
_IN0-: IC1.3 (S1), J2.2
_IN1+: IC1.10 (D3), J4.1
_IN1-: IC1.14 (S2), J4.2

Notes on the sheet:
Digital Supply
Isolators
Sensing
BNC
Analog Supply
Impedance monitor
ISO Power
Signal generator
5V to 3V3 level shifter
Stim ouput & RGB LED
DAC channel 1
ADC & Filters
DAC channel 2
Arduino
