uw-herron-lab/NeuroTest-Board/(commit log)

2026-05-29 NTB schematic
    Schematic made from analyzing the physical board and gerbers given. Added a schematic specific BOM (same items as other bom, just matches part numbers to the schematic)
    [NTB.kicad_sch, NTB_schematic_specific_BOM.csv]
2026-06-29 Detailed circuit diagrams and information
    Files from Oxford's initial NTB schematics
2026-07-01 updated NTB schematic files
    [NTB_schematic.kicad_sch]
2026-08-25 updated designators to match pictures from Mo
    [NTB_schematic.kicad_sch]
2026-09-11 BOM with Digikey parts for reference
    [NeuroTest board BOM and Digikey Order.xlsx]
